n0tcnj1eck4h/iiot-rollers/models/adapter.scad

$fn=60;

translate([0,0,-7])
linear_extrude(7)
difference(){
    circle(4);
    circle(1.5 + 0.2);
}

linear_extrude(10)

difference(){
    circle(4);
    intersection(){
        circle(3 + 0.1);
        translate([1.5 - 0.1,0,0]) square(6, center=true);
    }
}
