n0tcnj1eck4h/iiot-rollers/(list of files, cad)

Other CAD files:
models/mount.scad
