n0tcnj1eck4h/iiot-rollers/(commit log)

2025-05-24 porażka
    [adapter.scad, mount.scad]
2025-06-09 errm interface
    [mount.stl]
2025-06-09 move model
    [mount.scad]
